miquelr02/Miquel_Rodriguez_PLC4UNI/Diseño Electiva/Planos de la caja/Parte superior de lateral 1.jpg

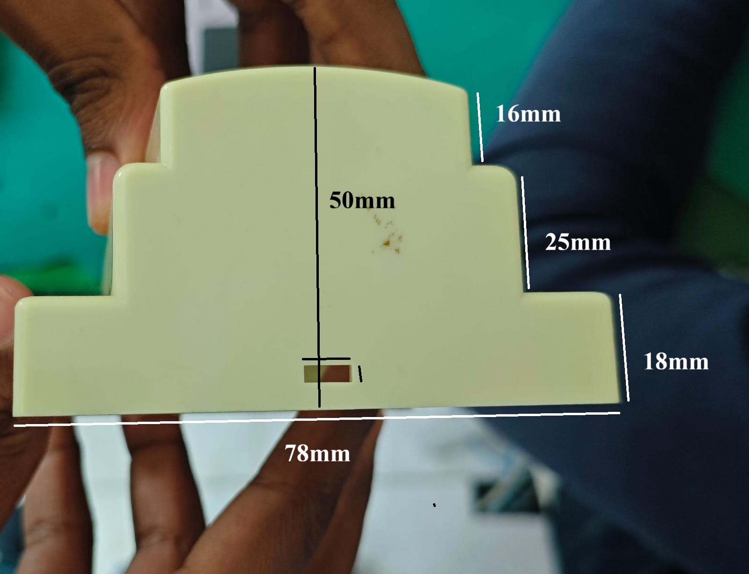
Diseño Electiva/Planos de la caja/Parte superior de lateral 1.jpg
