miquelr02/Miquel_Rodriguez_PLC4UNI/Tarea/Plantilla Especificación de requisitos de software Miquel.docx

Miquel Rodríguez Pimentel

2018-6619

Electiva mecatrónica

Especificación de requisitos de software

Proyecto: PLC 4UNI

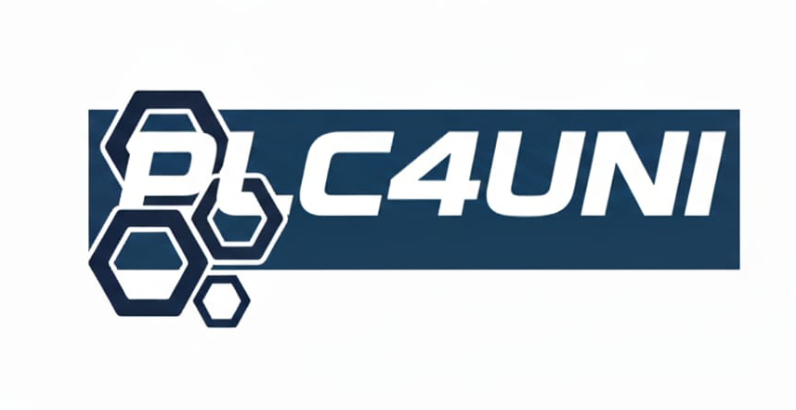
[picture p3: figure]

| | Septiembre 2025

Instrucciones para el uso de este formato

Este formato es una plantilla tipo para documentos de requisitos del software.

Está basado y es conforme con el estándar IEEE Std 830-1998.

Las secciones que no se consideren aplicables al sistema descrito podrán de forma justificada indicarse como no aplicables (NA).

Notas:

Los textos en color azul son indicaciones que deben eliminarse y, en su caso, sustituirse por los contenidos descritos en cada apartado.

Los textos entre corchetes del tipo “” permiten la inclusión directa de texto con el color y estilo adecuado a la sección, al pulsar sobre ellos con el puntero del ratón.

Los títulos y subtítulos de cada apartado están definidos como estilos de MS Word, de forma que su numeración consecutiva se genera automáticamente según se trate de estilos “Titulo1, Titulo2 y Titulo3”.

La sangría de los textos dentro de cada apartado se genera automáticamente al pulsar Intro al final de la línea de título. (Estilos Normal indentado1, Normal indentado 2 y Normal indentado 3).

El índice del documento es una tabla de contenido que MS Word actualiza tomando como criterio los títulos del documento.

Una vez terminada su redacción debe indicarse a Word que actualice todo su contenido para reflejar el contenido definitivo.

De la plantilla de formato del documento © & Coloriuris http://www.qualitatis.org

# Ficha del documento

Fecha | Revisión | Autor | Verificado dep. calidad.
Sept 2025 | 16/09 | Miquel Rodríguez Pimentel

Documento validado por las partes en fecha:

Por el cliente | Por la empresa suministradora
Fdo. D./ Dña | Fdo. D./Dña

# Contenido

# 1 Introducción

La introducción de la Especificación de requisitos de software (SRS) debe proporcionar una vista general de la SRS. Debe incluir el objetivo, el alcance, las definiciones y acrónimos, las referencias, y la vista general del SRS.

En el presente documento vamos dilucidar el proceso de desarrollo de un PLC educativo, pensado para estudiantes y su desarrollo al menos al inicio de su aprendizaje y que esta sea una herramienta fácil de conseguir, a un buen precio y además fácil de usar para cualquier automatización para principiantes.

El objetivo es que este PLC se convierta en un apoyo para todo el proceso del aprendizaje de los estudiantes, permitiendo algún margen de error sin daños graves al equipo. Una idea menos costosa e igual de efectiva.

## 1.1 Propósito

- Propósito del documento
- Audiencia a la que va dirigido

El propósito principal es definir los componentes, pasos y especificaciones para hacer un PLC que sea accesible para los estudiantes y que facilite el desarrollo en el área de automatización.

Este va dirigido a docentes, estudiantes, programadores y a instituciones que estén interesados en adquirir un dispositivo practico, funcional y accesible para su desarrollo en la automatización.

## 1.2 Alcance

- Identificación del producto(s) a desarrollar mediante un nombre
- Consistencia con definiciones similares de documentos de mayor nivel (ej. Descripción del sistema) que puedan existir

PLC 4UNI es un controlador lógico programable habilitado para estudiantes y principiantes en el área de la automatización, para que se les haga más económico y eficiente encontrar un equipo de estas características.

## 1.3 Personal involucrado

Nombre | Electiva de diseño mecatrónico
Rol | Desarrollo de diseño y hardware del PLC
Categoría profesional | Mecatrónica dirigida a automatización
Responsabilidades | Diseñar la interfaz y supervisar el desarrollo del PLC.
Información de contacto | 20186619tla.edu.do
Aprobación | Carlos Pichardo Viuque

Relación de personas involucradas en el desarrollo del sistema, con información de contacto.

Esta información es útil para que el gestor del proyecto pueda localizar a todos los participantes y recabar la información necesaria para la obtención de requisitos, validaciones de seguimiento, etc.

## 1.4 Definiciones, acrónimos y abreviaturas

Definición de todos los términos, abreviaturas y acrónimos necesarios para interpretar apropiadamente este documento. En ella se pueden indicar referencias a uno o más apéndices, o a otros documentos.

- PLC: Dispositivo electrónico que permite automatizar y controlar procesos mediante programación, en este caso con fines educativos.
- Sensor: Componente que detecta cambios en el entorno como luz, temperatura o posición y envía señales al PLC.
- Actuador: Dispositivo que recibe señales del PLC para realizar acciones específicas, como encender una luz o accionar un motor.
- GUI: (Graphical User Interface) Interfaz gráfica de usuario.
- IO: Inputs/Outputs (entradas y salidas de datos).
- EDU: Indica que el producto es de uso educativo.
- Señales digitales: Señales que solo pueden estar en dos estados (0 y 1), utilizadas para lógica de control.

## 1.5 Referencias

Ref | Titulo | Ruta | Fecha | Autor
1 | Manual del PLC educativo | /Documentos/PLC_Educativo/Manual.pdf | 1/09/2025 | Equipo de desarrollo
2 | Guía de programación de PLC | /Documentos/PLC_Educativo/Guía_Programacion.pdf | 20/08/2025 | Equipo de desarrollo

Relación completa de todos los documentos relacionados en la especificación de requisitos de software, identificando de cada documento el titulo, referencia (si procede), fecha y organización que lo proporciona.

## 1.6 Resumen

- Descripción del contenido del resto del documento
- Explicación de la organización del documento

Descripción del contenido: El documento incluye el propósito y alcance del proyecto, los términos y acrónimos necesarios, referencias de soporte, personal involucrado y sus responsabilidades, así como los requisitos funcionales y no funcionales del PLC. Se detallan las características de la interfaz, colores y funcionalidades diseñadas especialmente para estudiantes.

Organización del documento: La información se organiza de manera que el lector pueda comprender primero el objetivo y alcance, luego los términos clave y referencias, seguido por el personal responsable y finalmente los requisitos y funcionalidades del sistema, proporcionando una visión completa y coherente del PLC educativo y sus usos en un entorno académico.

# 2 Descripción general

## 2.1 Perspectiva del producto

El PLC educativo es un producto independiente, diseñado específicamente para fines académicos y de formación práctica en el área de la automatización y el control. Su desarrollo no depende de un sistema mayor, aunque puede complementarse con equipos de laboratorio como sensores, actuadores, simuladores y software de programación, lo que amplía sus posibilidades de uso en actividades educativas.

Este producto busca ofrecer a los estudiantes, un entorno seguro y sencillo para experimentar con lógica de control, programación y manejo de señales digitales y analógicas. Gracias a su interfaz intuitiva y su diseño visual con colores cálidos y suaves, se integra de manera amigable en entornos de aprendizaje, fomentando la participación y la comprensión de los conceptos.

## 2.2 Funcionalidad del producto

EL PLC educativo esta diseñado para ofrecer a los estudiantes una herramienta práctica y sencilla con la cual puedan comprender los fundamentos de la programación y el control de procesos automatizados. Sus funciones principales son:

Programación básica avanzada: Permite a los estudiantes crear, modificar y ejecutar programas de control mediante un entorno accesible y pensando para la enseñanza.

Manejo de entradas y salidas: Reconoce señales digitales y analógicas provenientes de sensores, y envía señales de control hacia actuadores como luces, motores o alarma

Interfaz amigable: Cuenta con un sistema de uso intuitivo, con indicadores visuales claros y un diseño en colores cálidos y suaves que favorecen la concentración y el aprendizaje

Simulación educativa: Posibilita la recreación de escenarios sencillos de automatización, permitiendo que los estudiantes prueben y entiendan la lógica de control.

## 2.3 Características de los usuarios

Tipo de usuario | Estudiantes de técnico superior y universitarios
Formación | Conocimientos básicos en electrónica, electricidad y automatización
Habilidades | Capacidad par seguir instrucciones de practicas de laboratorio, interpretar esquemas sencillos, realizar conexiones básicas de sensores y actuadores.
Actividades | Los usuarios emplearán el PLC para desarrollar ejercicios prácticos de automatización, aprender lógica de control, probar programas en escenarios simulados y ejecutar automatización que integre sensores y actuadores.

Descripción de los usuarios del producto, incluyendo nivel educacional, experiencia y experiencia técnica.

## 2.4 Restricciones

Descripción de aquellas limitaciones a tener en cuenta a la hora de diseñar y desarrollar el sistema, tales como el empleo de determinadas metodologías de desarrollo, lenguajes de programación, normas particulares, restricciones de hardware, de sistema operativo etc.

El diseño y desarrollo del PLC presenta algunas limitaciones que deben ser tomadas en cuenta para garantizar su correcto funcionamiento y accesibilidad en el entorno académico:

- Hardware limitado: El dispositivo contará con una cantidad reducida de entradas y salidas digitales y analógicas, suficientes para fines educativos, pero no para aplicaciones industriales.
- Lenguaje de programación: Se utilizará un lenguaje sencillo, estandarizado y que se enfoque en el mercado para reforzar el aprendizaje y que este pueda llevar al campo laboral.
- Compatibilidad de software: El sistema esta diseñado para funcionar en sistemas operativos comunes como Windows y Linux, evitando instalaciones y búsquedas de otros sistemas.
- Normas de seguridad: El producto debe cumplir con estándares básicos de seguridad eléctrica y de laboratorio, evitando riesgos para los estudiantes.
- Acceso a hardware educativo básico: Se considera que los estudiantes tendrán acceso a sensores y actuadores simples para realizar prácticas. La falta de estos componentes limitaría el aprendizaje.
- Recursos de laboratorio: Se espera que el dispositivo se utilice en lugares con energía eléctrica estable y condiciones seguras de laboratorio. Si estas condiciones no están garantizadas el uso del PLC puede verse restringido.

## 2.5 Suposiciones y dependencias

Descripción de aquellos factores que, si cambian, pueden afectar a los requisitos. Por ejemplo, una asunción puede ser que determinado sistema operativo está disponible para el hardware requerido. De hecho, si el sistema operativo no estuviera disponible, la SRS debería modificarse.

El desarrollo del PLC se apoya en ciertos factores que se consideran estables, pero al tener variación en alguno de ellos podrían afectar los requisitos.

- Disponibilidad de sistemas operativos comunes: Asumiendo que todos los equipos posean Windows o Linux.
- Acceso y hardware educativo básico: Se considera que los estudiantes tendrán acceso a sensores y actuadores simples para realizar las practicas.
- Recursos de laboratorios: Se asume que el producto será utilizado en entornos con energía eléctrica estable y condiciones seguras de laboratorio. Si estas condiciones no se garantizan el uso del PLC se verá restringido.

## 2.6 Evolución previsible del sistema

Identificación de futuras mejoras al sistema, que podrán analizarse e implementarse en un futuro.

Esta pensado como una primera versión funcional y accesible, pero se prevé que mas adelante pueda actualizar y mejorar capacidades para adaptarse a nuevas necesidades de enseñanza.

- Ampliación de entradas y salidas: Incorporar mayor número de puertos digitales y analógicos
- Conectividad inalámbrica: Añadir soporte para Wi-Fi o bluetooh facilitando la conexión con dispositivos móviles o entornos de simulación en la nube.
- Entorno de programación: Incluir lenguajes visuales (en bloques) o integración de plataformas como Arduino o Python, para mayor diversificación del aprendizaje.
- Compatibilidad multiplataforma: Extender el uso del software a sistemas operativos adicionales, incluyendo macOS y aplicaciones móviles.

# 3 Requisitos específicos

Número de requisito | RF-027
Nombre de requisito | Entradas digitales configurables
Tipo | [ ] Requisito | [ ] Restricción
Fuente del requisito | Necesidad educativa/practica de control básico
Prioridad del requisito | [ ] Alta/Esencial | [ ] Media/Deseado | [ ] Baja/ Opcional

## 3.1 Requisitos comunes de los interfaces

### 3.1.1 Interfaces de usuario

El sistema contará con una interfaz gráfica amigable e intuitiva para estudiantes y docentes, con las siguientes características:

- Pantalla principal con menú de opciones
- Editor de programas con bloques gráficos y código textual
- Colores diferenciados para entradas, salidas y operaciones lógicas
- Mensajes de error y de alertas claros en caso de advertencias o error en alguna configuración
- Panel de simulación en tiempo real que muestre el estado de las entradas y las salidas.

### 3.1.2 Interfaces de hardware

El sistema deberá contar con conexiones físicas para interactuar con el entorno.

- Entradas digitales: Mínimo 8, compatibles con sensores de 24 VDC.
- Entradas analógicas: Mínimo 2, rango 0-10 V para potenciómetros o transductores.
- Salidas digitales: Mínimo 8, tipo rele o transistor para control de actuadores.
- Puerto USB: Para conexión con la PC y carga de programas.
- Pantalla LCD: Para mostrar estados básicos sin PC.

### 3.1.3 Interfaces de comunicación

Describir los requisitos del interfaces de comunicación si hay comunicaciones con otros sistemas y cuales son las protocolos de comunicación.

El sistema deberá integrarse con software complementarios para su programación y simulación:

- IDE propio (software educativo del PLC)
1. Permitir programación, simulación y carga al hardware.
2. Formato de interfaz: archivos de proyecto
- Exportación de datos: compatibilidad para guardar programas en formato texto.
- Integracion opcional: con software SCADA educativo mediante protocolo OPC-UA.

## 3.2 Requisitos funcionales

El software deberá realizar las siguientes acciones principales:

- Validación de entradas antes de su procesamiento (valores dentro del rango permitido).
- Procesamiento de la lógica definida por el usuario
- Generación de salidas en función de entradas y condiciones programadas.
- Manejo de errores y recuperación automática en caso de fallos de comunicación o ejecución.
- Registro de eventos y resultados de simulación para retroalimentación al usuario.

### 3.2.1 Requisito funcional 1

Nombre: Validación de entradas

Descripción: El sistema verificara que las señales de entrada estén dentro del rango permitido antes de procesarlas

### 3.2.2 Requisito funcional 2

Nombre: Ejecución de lógica de control.

Descripción: El sistema deberá ejecutar la lógica programada por el usuario de acuerdo con las instrucciones definidas.

### 3.2.3 Requisito funcional 3

Nombre: Simulación en tiempo real

Descripción: El software permitirá al usuario simular el comportamiento del programa sin necesidad de cargarlo en el hardware.

### 3.2.4 Requisito funcional n

Nombre: Comunicación con hardware PLC.

Descripción: El sistema deberá enviar y recibir datos correctamente entre el software de programación y el hardware del PLC a través del USB.

## 3.3 Requisitos no funcionales

### 3.3.1 Requisitos de rendimiento

- El sistema debe permitir la ejecución de hasta 20 usuarios simultáneos en la plataforma de simulación sin degradar el rendimiento.
- El 95% de las operaciones (compilación, carga de programa y simulación) deberán completarse en menos de 2 segundos.
- El hardware del PLC debe poder procesar programas de hasta 200 instrucciones sin pérdida de velocidad.
- El software debe poder gestionar un promedio de 50 interacciones por minuto durante las practicas sin fallos.

### 3.3.2 Seguridad

- El acceso al software estará protegido por usuarios y contraseñas diferenciados para estudiantes y docentes.
- Se implementarán logs de actividad que registren acciones críticas.
- Toda comunicación entre PC y PLC deberá usar protocolo seguro (ej. Cifrado básico en USB o Modbus).
- El sistema verificará la integridad de archivos de programas antes de cargarlos en el hardware para evitar fallos maliciosos o accidentales.

### 3.3.3 Fiabilidad

- El sistema deberá tener tasa de error menor al 2% en operaciones de compilación y carga.
- El hardware del PLC deberá mantener un tiempo medio entre fallos (MTBF) mínimo de 5000 horas.
- El software deberá recuperarse automáticamente en caso de pérdida de conexión con PLC en un máximo de 5 segundos.

### 3.3.4 Disponibilidad

- El sistema deberá estar disponible al menos 99% del tiempo de uso en horario académico (8:am-8:00 pm).
- Las actualizaciones del software no deberán dejarlo inactivo por más de 2 horas seguidas.
- El hardware sebera encender y estar listo para uso en un máximo de 15 segundos.

### 3.3.5 Mantenibilidad

- El software deberá permitir actualizaciones periódicas sin necesidad de reinstalar completamente el sistema.
- El equipo de desarrollo será responsable del mantenimiento correctivo (errores y fallos).
- Los docentes podrán realizar mantenimiento preventivo, como la generación de reportes semanales de uso y estadística de acceso.
- Las tareas de mantenimiento no deberán superar el 5% del tiempo de operación mensual.

### 3.3.6 Portabilidad

- El software deberá funcionar en Windows 10 o superior y ser adaptable a Linux en futuras versiones.
- Al menos el 80% del código fuente será independiente del sistema operativo, garantizado su migración otros entornos.}
- Los programas desarrollados deberán exportarse en formatos estándar para reutilización en otras plataformas.
- La aplicación deberá poder ejecutarse en equipos con mínimo 4 GB de RAM y procesador i3 o equivalente.

## 3.4 Otros requisitos

- Requisitos culturales y educativos: El sistema debe estar disponible en idioma español, con opción futura a inglés para facilitar su uso internacional.
- Requisitos legales: Cumplir con normativas de seguridad eléctrica (24 VDC seguro) y licencias de software libre o académico.
- Requisitos políticos: El producto debe alinearse con programas nacionales de educación técnica y profesional.

# 4 Apéndices

En esta sección se podrán incluir:

- Diagramas eléctricos y de conexión del PLC.
- Ejemplos de prácticas preconfiguradas.
- Glosario de símbolos usados en diagramas ladder.
- Manuales de usuario y guías rápidas para estudiantes u y docentes.

Descripción de requisitos del sofware

Modelo de ingeniería [Nombre documento] 0.3 Pág. 3

PLC 4UNI Especificación de requisitos de software Electiva Pág. 5

Especificación de requisitos de software Rev. Pág. 4
