miquelr02/Miquel_Rodriguez_PLC4UNI/Diseño Electiva/Planos de la caja/parte inferior de lateral 1.jpg

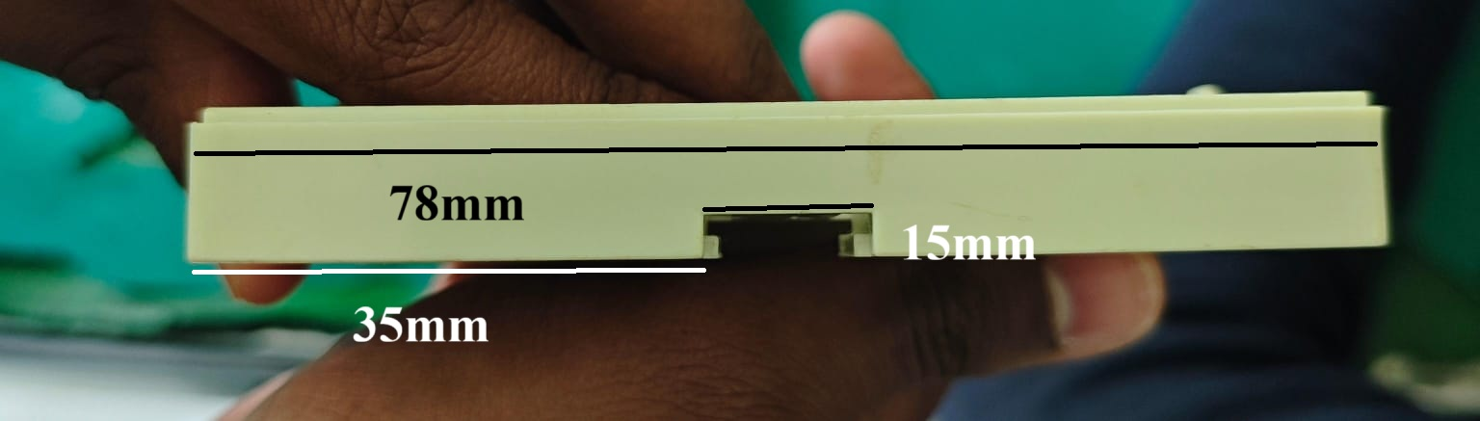
Diseño Electiva/Planos de la caja/parte inferior de lateral 1.jpg
