miquelr02/Miquel_Rodriguez_PLC4UNI/Render/Render de frente.png

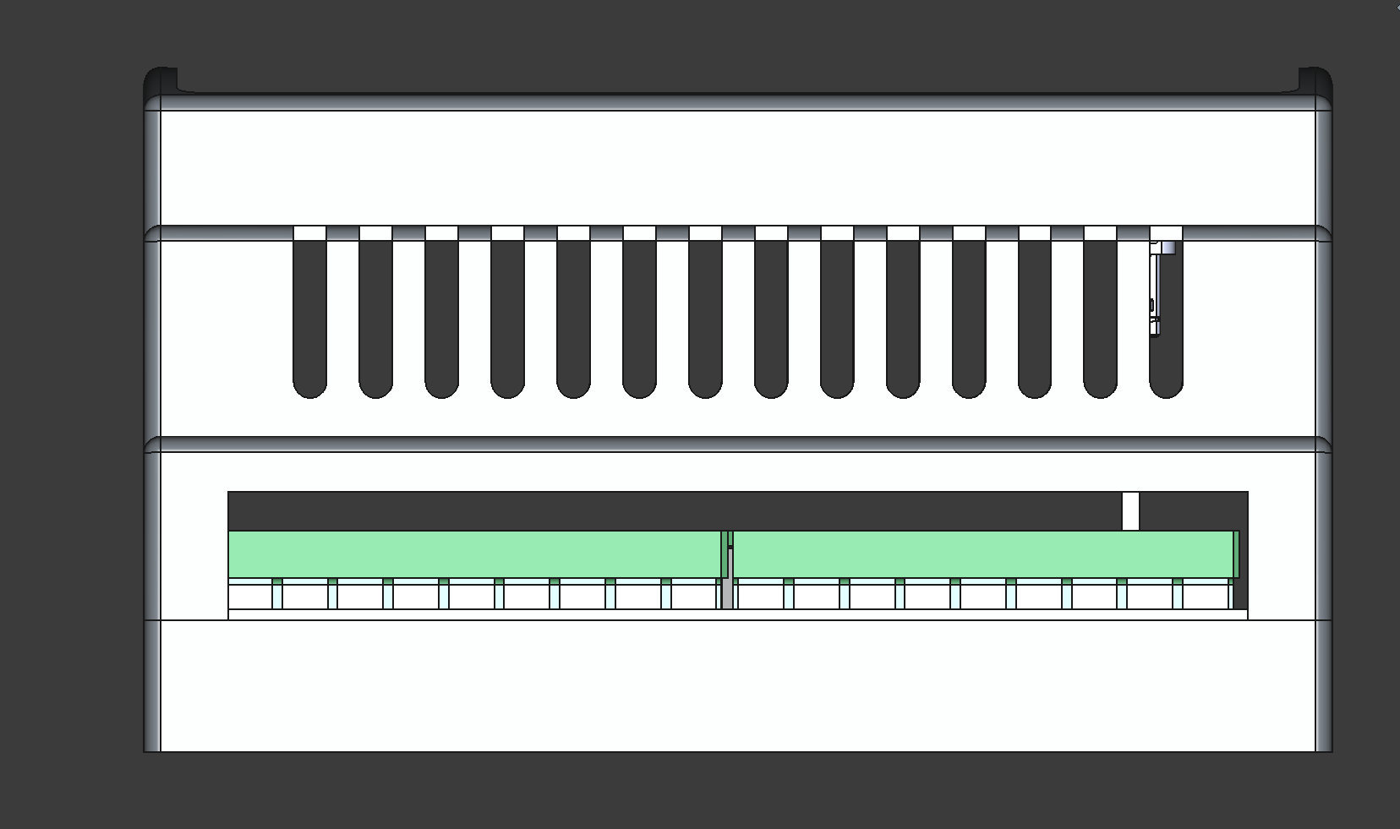
Render/Render de frente.png
