miquelr02/Miquel_Rodriguez_PLC4UNI/Render/Render Lateral con etiqueta.png

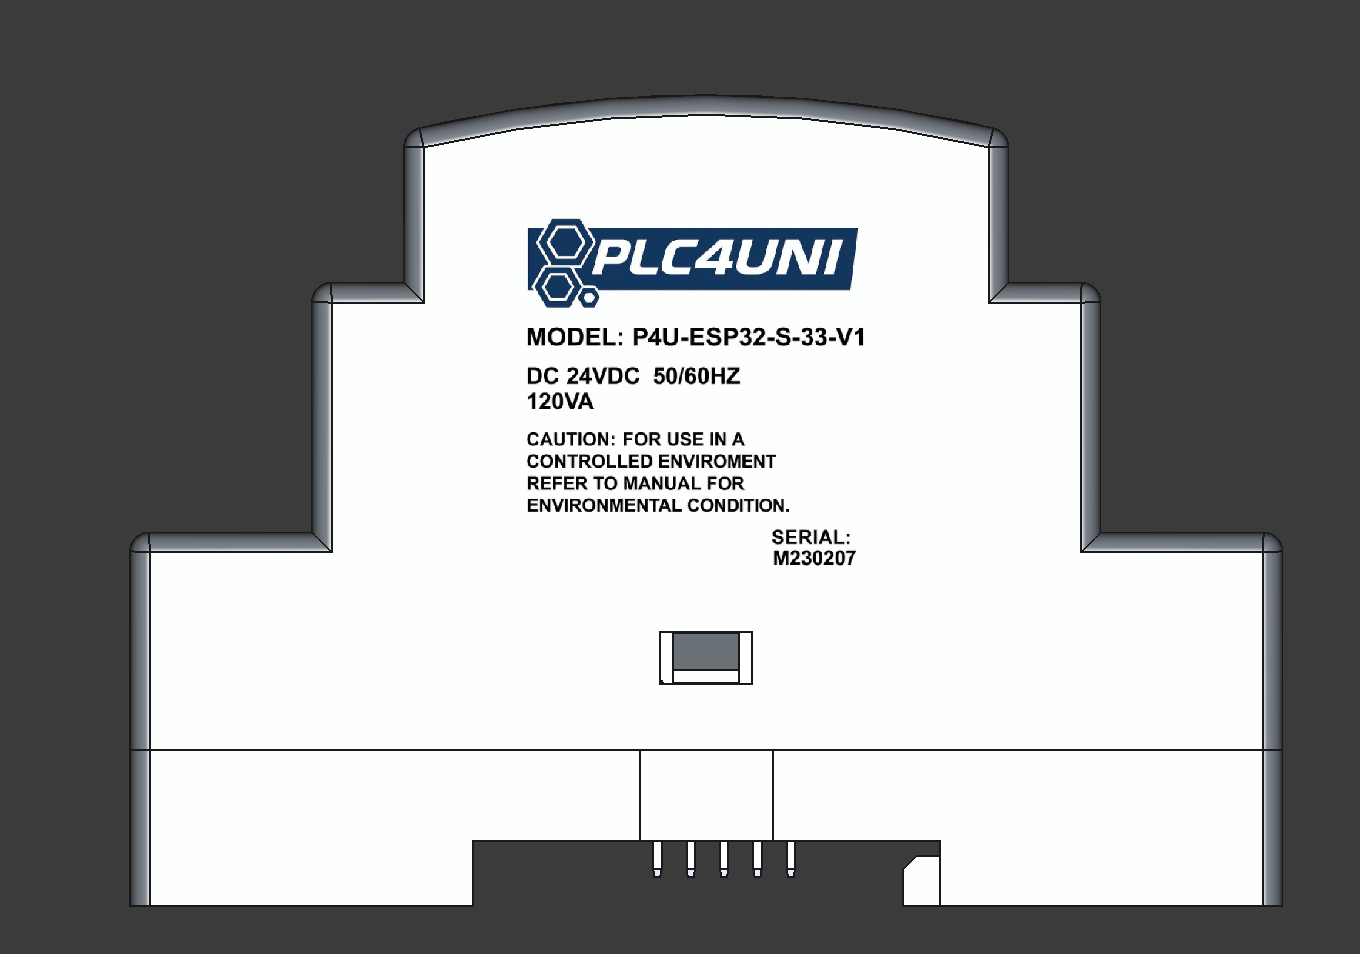
Render/Render Lateral con etiqueta.png
