miquelr02/Miquel_Rodriguez_PLC4UNI/Render/Render Vista Isométrica.png

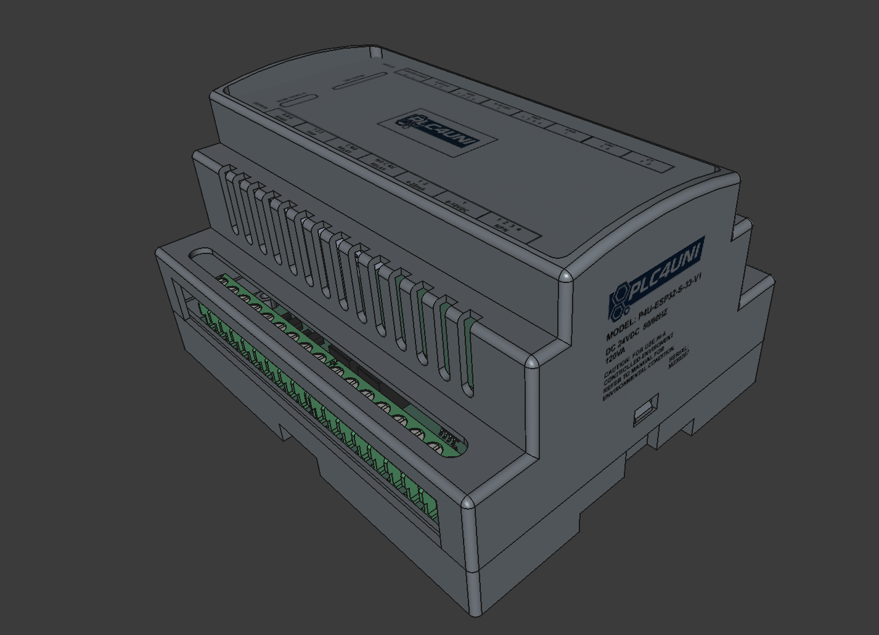
Render/Render Vista Isométrica.png
