miquelr02/Miquel_Rodriguez_PLC4UNI/Render/RENDER.png

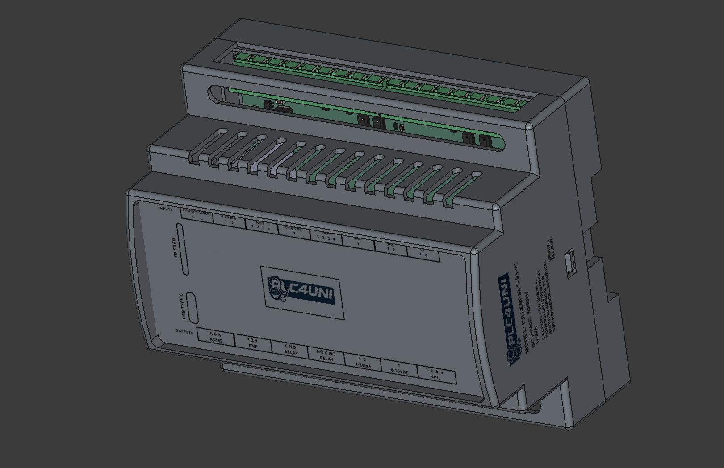
Render/RENDER.png
