miquelr02/Miquel_Rodriguez_PLC4UNI/Diseño Electiva/FreeCad/Inferior.FCStd

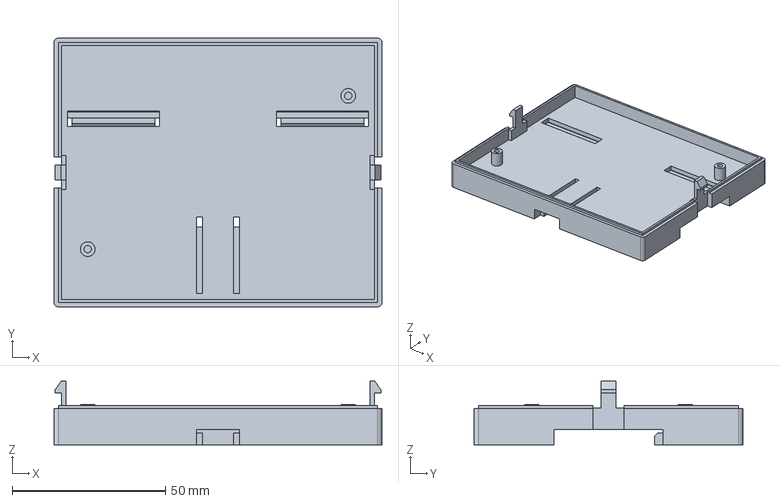
[picture p11: CAD file, 2025-10-09]
Diseño Electiva/FreeCad/Inferior.FCStd
107.0 x 87.7 x 20.8 mm
