miquelr02/Miquel_Rodriguez_PLC4UNI/Tarea 4/MSD-4-A (1).step

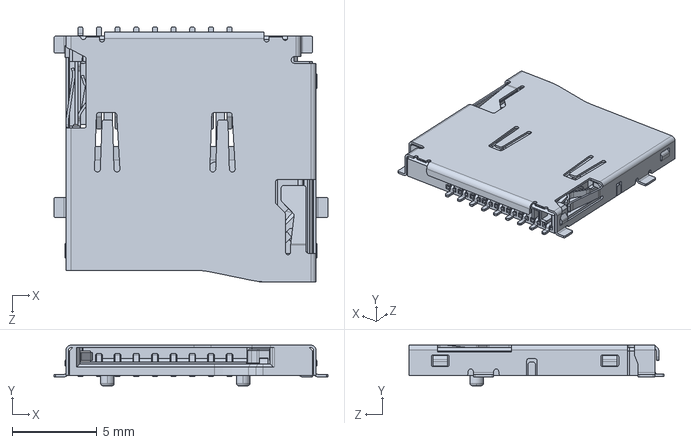
[picture p12: CAD file, 2025-12-12]
Tarea 4/MSD-4-A (1).step
16.1 x 2.40 x 15.0 mm
