miquelr02/Miquel_Rodriguez_PLC4UNI/Diseño Electiva/FreeCad/Superior.FCStd

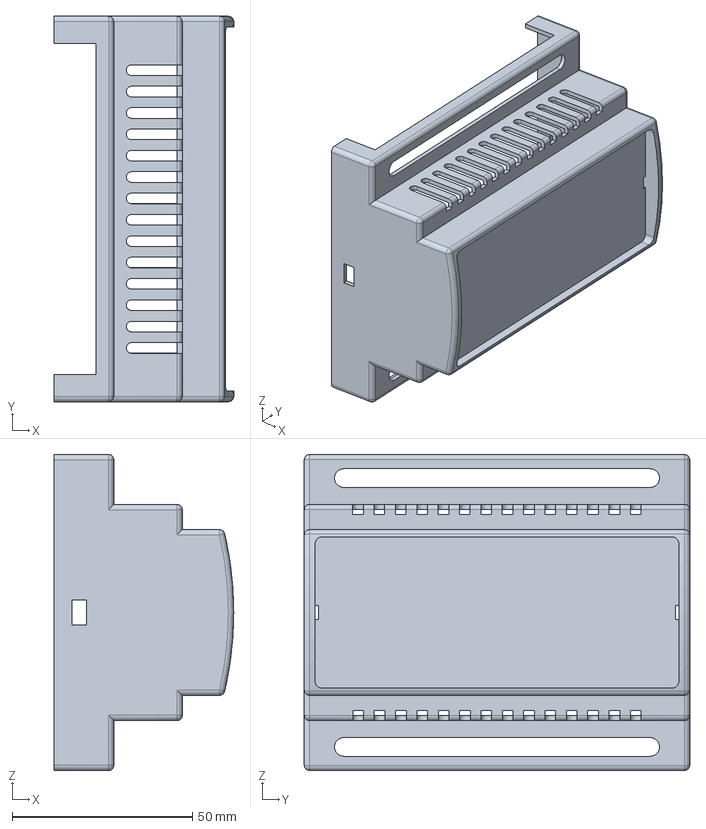
[picture p13: CAD file, 2025-10-09]
Diseño Electiva/FreeCad/Superior.FCStd
49.8 x 107.0 x 87.7 mm
