miquelr02/Miquel_Rodriguez_PLC4UNI/Tarea 4/USB Type C Port (SMD Type).STEP

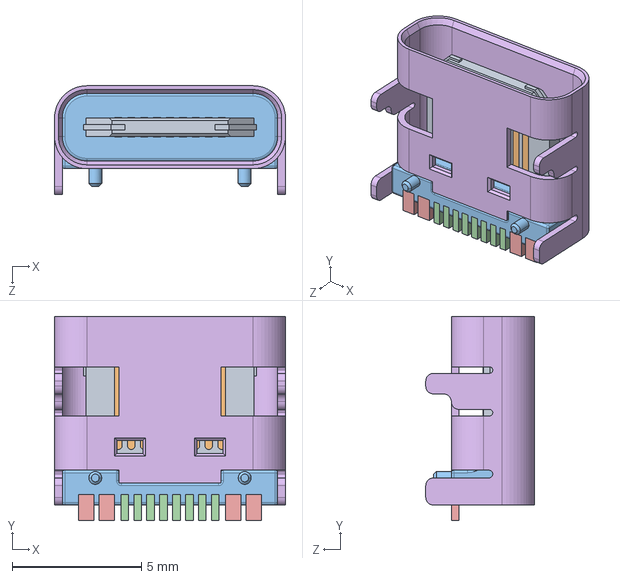
[picture p14: CAD file, 2025-12-12]
Tarea 4/USB Type C Port (SMD Type).STEP
8.94 x 7.90 x 4.20 mm
