miquelr02/Miquel_Rodriguez_PLC4UNI/Tarea 4/2x5 Male Pin Header .STEP

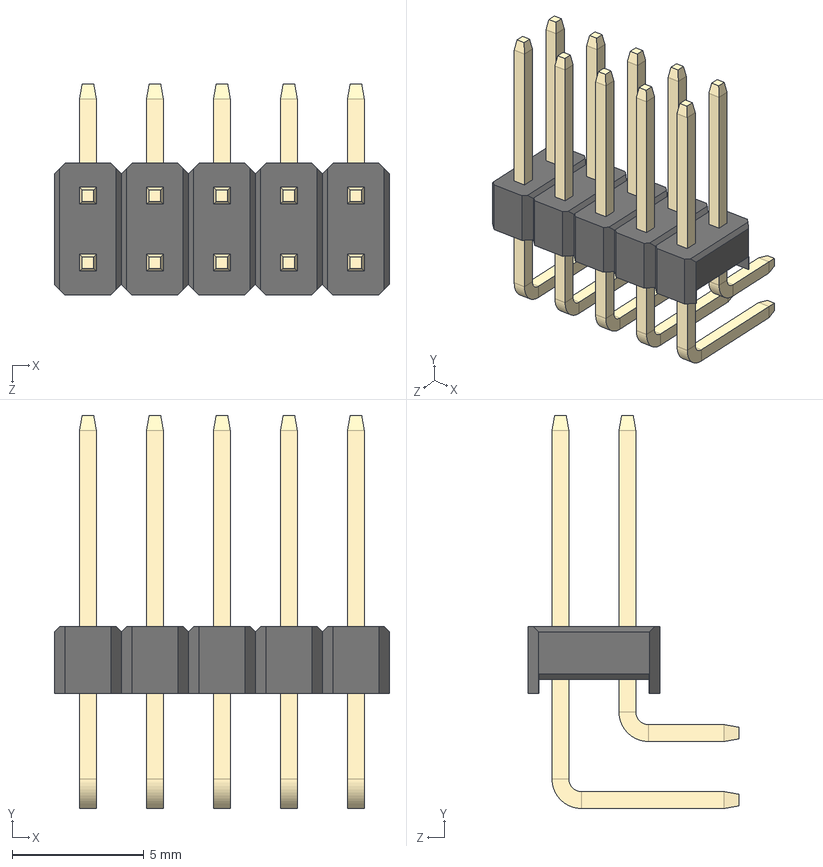
[picture p15: CAD file, 2025-12-12]
Tarea 4/2x5 Male Pin Header .STEP
12.7 x 14.9 x 8.00 mm
