miquelr02/Miquel_Rodriguez_PLC4UNI/Tarea 4/PCB Vertical .DXF

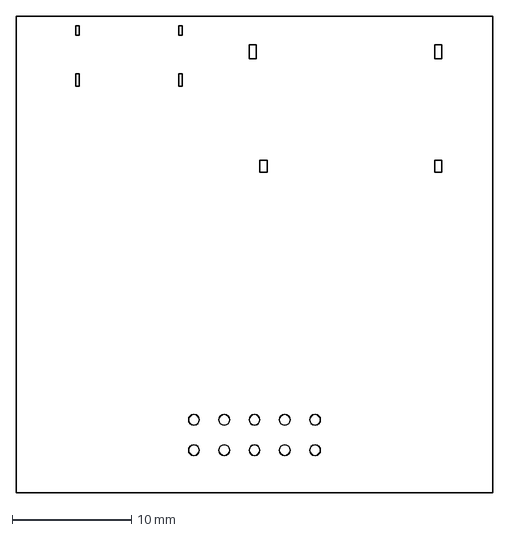
[picture p16: CAD file, 2025-12-12]
Tarea 4/PCB Vertical .DXF
40.0 x 40.0 mm
