miquelr02/Miquel_Rodriguez_PLC4UNI/Tarea 4/PLC4uni.FCStd

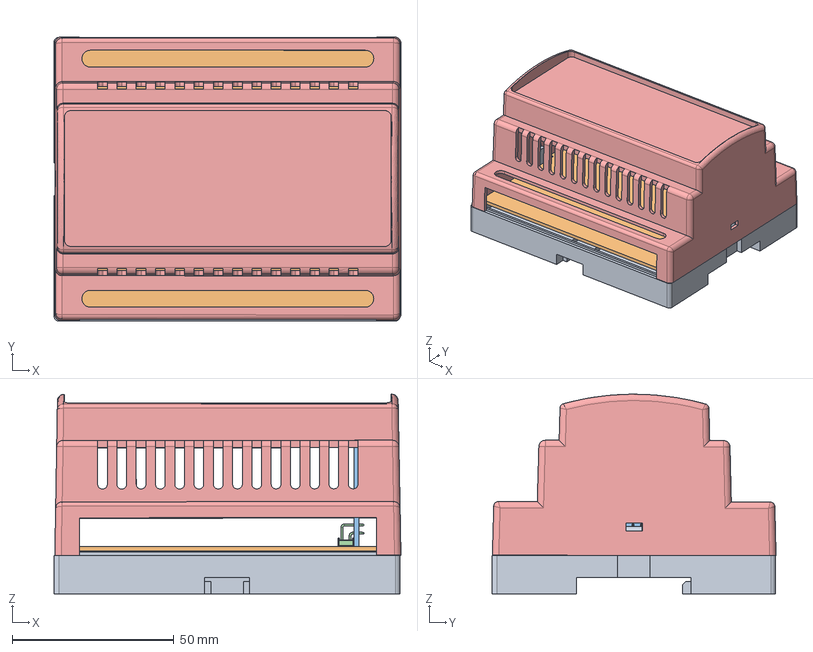
[picture p17: CAD file, 2025-12-12]
Tarea 4/PLC4uni.FCStd
107.2 x 87.8 x 61.7 mm
PLC–4–UNI–209 Franjelis L._001
PLC4uni PCB_001
PLC4uni PCB_Vertical_001
2x5 male PIn Header Angle_001
PLC Part-1_001
