miquelr02/Miquel_Rodriguez_PLC4UNI/Tarea 3/Nivara.kicad_pcb

## KiCad design Tarea 3/Nivara.kicad_pcb (2025-12-01)

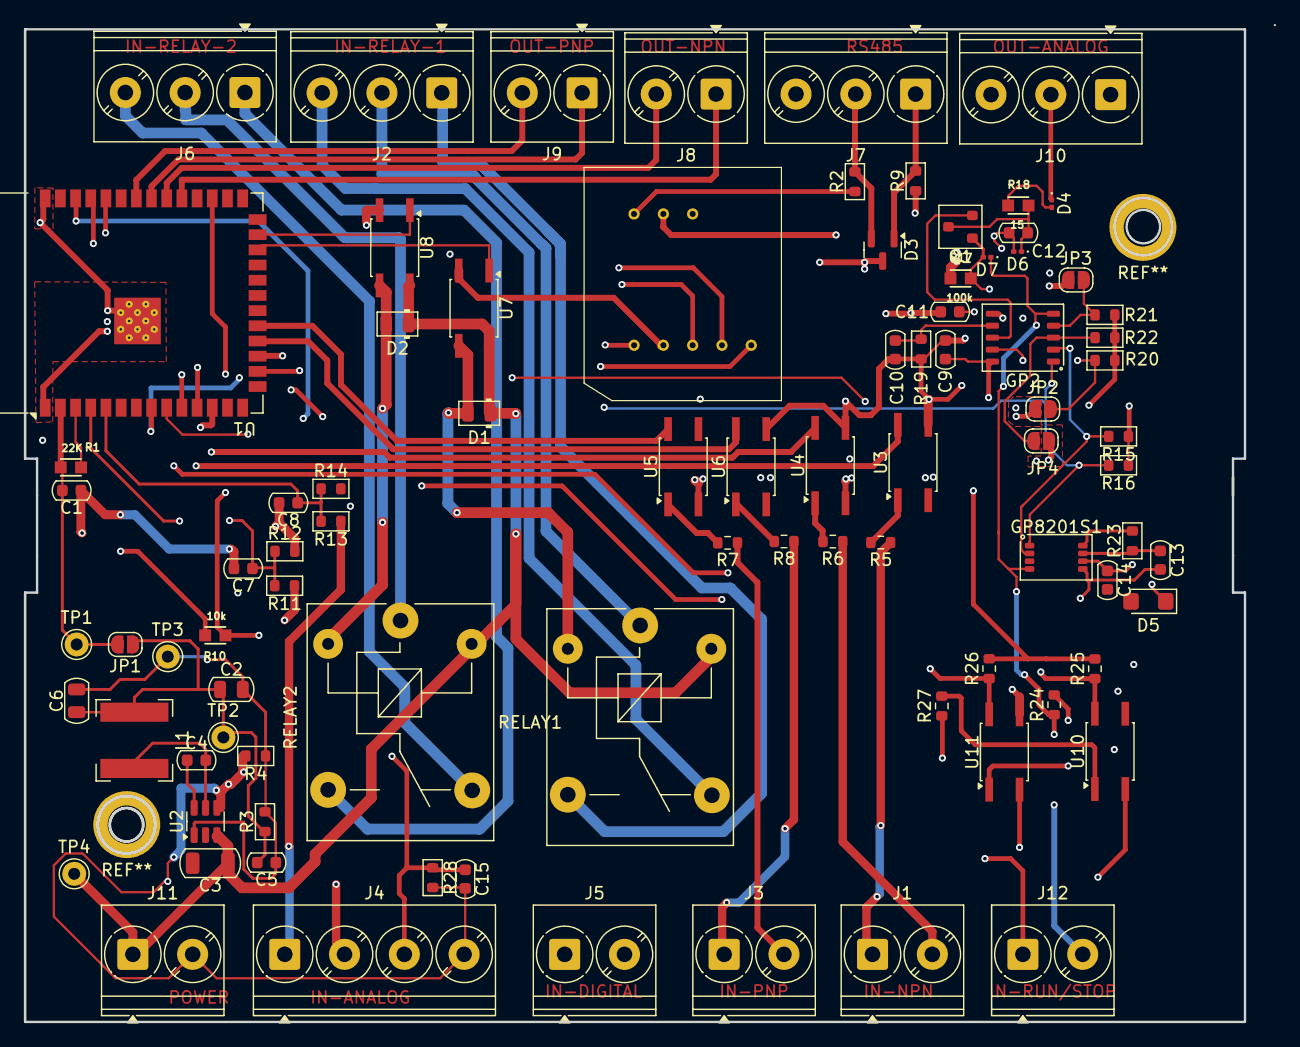
[picture p19: board Nivara.kicad_pcb from above]

Board: 4 copper layers, 104.5 x 83.3 mm, 87 parts (0 on the bottom side), 68 nets.

Parts:
C1, C9, C11, C13: 1uF; C_0603_1608Metric
C2, C6: 22uF; C_0805_2012Metric
C3: 10uF; C_1206_3216Metric
C4, C7, C8, C14, C15: 100nF; C_0603_1608Metric
C5: 100PF; C_0603_1608Metric
C10: 220pF; C_0603_1608Metric
C12: 0.1uF; C_0603_1608Metric
D1, D2: CD4148WS; D_0805_2012Metric
D3: SM712_SOT23; SOT-23
D4: 1N4007; D_0201_0603Metric
D5: SMF24A; D_SMF
D6, D7: SMF24A; D_0201_0603Metric
GP2: SSOP-10_3.9x4.9mm_P1.00mm
GP8201S1: OnSemi_Micro8
J1: IN-NPN; TerminalBlock_Phoenix_PT-1,5-2-5.0-H_1x02_P5.00mm_Horizontal
J2: IN-RELAY-1; TerminalBlock_Phoenix_PT-1,5-3-5.0-H_1x03_P5.00mm_Horizontal
J3: IN-PNP; TerminalBlock_Phoenix_PT-1,5-2-5.0-H_1x02_P5.00mm_Horizontal
J4: IN-ANALOG; TerminalBlock_Phoenix_PT-1,5-4-5.0-H_1x04_P5.00mm_Horizontal
J5: IN-DIGITAL; TerminalBlock_Phoenix_PT-1,5-2-5.0-H_1x02_P5.00mm_Horizontal
J6: IN-RELAY-2; TerminalBlock_Phoenix_PT-1,5-3-5.0-H_1x03_P5.00mm_Horizontal
J7: RS485; TerminalBlock_Phoenix_PT-1,5-3-5.0-H_1x03_P5.00mm_Horizontal
J8: OUT-NPN; TerminalBlock_Phoenix_PT-1,5-2-5.0-H_1x02_P5.00mm_Horizontal
J9: OUT-PNP; TerminalBlock_Phoenix_PT-1,5-2-5.0-H_1x02_P5.00mm_Horizontal
J10: OUT-ANALOG; TerminalBlock_Phoenix_PT-1,5-3-5.0-H_1x03_P5.00mm_Horizontal
J11: POWER; TerminalBlock_Phoenix_PT-1,5-2-5.0-H_1x02_P5.00mm_Horizontal
J12: IN-RUN/STOP; TerminalBlock_Phoenix_PT-1,5-2-5.0-H_1x02_P5.00mm_Horizontal
JP1, JP2, JP3, JP4: SolderJumper_2_Open; SolderJumper-2_P1.3mm_Open_RoundedPad1.0x1.5mm
L1: 6.8uH; L_Bourns-SRN6028
Q1: AO3401A; SOT-23
R1: 22K; R_0603
R2, R9, R28: 120; R_0603_1608Metric
R3, R4: 22k; R_0603_1608Metric
R5, R6, R7, R8, R24, R27: 910; R_0603_1608Metric
R10: 10k; R_0603
R11, R13: 51k; R_0603_1608Metric
R12, R14: 16k; R_0603_1608Metric
R15, R16: 4.7k; R_0603_1608Metric
R17: 100k; R_0603
R18: 15; R_0603
R19: 2.5k; R_0603_1608Metric
R20, R21, R22, R23: 10k; R_0603_1608Metric
R25, R26: 412; R_0603_1608Metric
RELAY1, RELAY2: SANYOU_SRD_Form_C; Relay_SPDT_SANYOU_SRD_Series_Form_C
TP1, TP2, TP3, TP4: TestPoint; Pin_D1.0mm_L10.0mm
U1: ESP32-S3-WROOM-1
U2: AP63200WU; TSOT-23-6
U3, U4, U5, U6, U7, U8, U10, U11: LTV-357TB; SO-4_4.4x3.6mm_P2.54mm
U9: RSM3485ECHT

Connections:
+3.3V: C1.2, JP1.2 (B), R1.1, R10.1, R15.1, R16.1, R25.2, R26.2, TP1.1, U1.2 (3V3), U9.1 (VCC)
/BOARD/ANAG_0-10-IN: J4.2, R11.1
/BOARD/ANAG_0-32-IN: J4.1, R13.1
/BOARD/ANAG_VOL-OUT: C14.1, D5.1 (A1), GP8201S1.6 (VOUT)
/BOARD/DIG_IN/OUT_DIGITAL_0: R25.1, U1.10 (IO17), U10.4
/BOARD/DIG_IN/OUT_DIGITAL_1: R26.1, U1.11 (IO18), U11.4
/BOARD/IN-PNP1: J3.1, R8.1
/BOARD/IN-PNP2: J3.2, R7.1
/BOARD/INPUT_NPN/OUTPUT_NPN1: U1.12 (IO8), U3.4
/BOARD/INPUT_NPN/OUTPUT_NPN2: U1.17 (IO9), U4.4
/BOARD/INPUT_PNP/OUTPUT-PNP1: U1.18 (IO10), U6.4
/BOARD/INPUT_PNP/OUTPUT-PNP2: U1.19 (IO11), U5.4
/BOARD/IN_DIGITAL_0: J5.2, U10.2
/BOARD/IN_DIGITAL_1: J5.1, U11.2
/BOARD/IN_NPN1: J1.1, R5.1
/BOARD/IN_NPN2: J1.2, R6.1
/BOARD/IN_mA-ANAG: C15.1, J4.3, R28.1, U1.38 (IO2)
/BOARD/OUTPUT-PNP1: J9.1, U1.33 (IO40)
/BOARD/OUTPUT-PNP2: J9.2, U1.34 (IO41)
/BOARD/OUTPUT_NPN1: J8.1, U1.31 (IO38)
/BOARD/OUTPUT_NPN2: J8.2, U1.32 (IO39)
/BOARD/OUT_4-20mA-ANAG: D4.1 (K), J10.2
/BOARD/RELA2_NO: J6.1, RELAY2.3
/BOARD/RELAY1_COS: J2.2, RELAY1.1
/BOARD/RELAY1_NC: J2.3, RELAY1.4
/BOARD/RELAY1_NO: J2.1, RELAY1.3
/BOARD/RELAY2_COS: J6.2, RELAY2.1
/BOARD/RELAY2_NC: J6.3, RELAY2.4
/BOARD/RELAY-SETUP/ACT_RELAY1: U1.24 (IO47), U7.1
/BOARD/RELAY-SETUP/ACT_RELAY2: U1.25 (IO48), U8.1
/BOARD/RS485-DRIVER/UART-IN: U1.37 (TXD0), U9.3 (TXD)
/BOARD/RS485-DRIVER/UART-OUT: U1.36 (RXD0), U9.4 (RXD)
/BOARD/RS485-DRIVER/~TX/RX: U1.16 (IO46), U9.5 (CON)
/BOARD/RS-485A: D3.1 (A1), J7.1, R9.2
/BOARD/RS-485B: D3.2 (A2), J7.2, R2.2
/BOARD/VOLTAGE entrada/ANAG_0-10-OUT: C7.1, R11.2, R12.1, U1.4 (IO4)
/BOARD/VOLTAGE entrada/ANAG_0-32-OUT: C8.1, R13.2, R14.1, U1.5 (IO5)
/BOARD/salida mA/SCLK_OUT: GP2.1 (SCLK), GP8201S1.1 (SCLK), R16.2, U1.9 (IO16)
/BOARD/salida mA/SDA_OUT: GP2.2 (SDA), GP8201S1.2 (SDA), R15.2, U1.8 (IO15)
/BOARD/~RUN/STOP: J12.1, R10.2, U1.29 (IO36)
GND: C1.1, C3.2, C7.2, C8.2, C9.2, C10.2, C11.2, C12.2, C13.2, C14.2, C15.2, D3.3 (common), D5.2 (A2), D6.2 (A2), GP2.6 (GND), GP8201S1.5 (GND), J4.4, J7.3, J10.3, J11.2, J12.2, JP2.1 (A), JP3.1 (A), JP4.1 (A), R4.2, R12.2, R14.2, R17.2, R19.2, R28.2, U1.1 (GND), U1.40 (GND), U1.41 (GND), U2.4 (GND), U3.2, U3.3, U4.2, U4.3, U5.2, U5.3, U6.2, U6.3, U7.2, U8.2, U9.2 (GND), U10.3, U11.3
unnamed: D1.2 (A), RELAY1.2, U7.3
unnamed: D2.2 (A), RELAY2.2, U8.3
unnamed: D4.2 (A), R18.2
unnamed: C12.1, D6.1 (A1), Q1.3 (D), R18.1
unnamed: C11.1, D7.2 (A2), Q1.1 (G), R17.1
unnamed: GP2.3 (A0), JP4.2 (B), R22.2
unnamed: GP2.4 (A1), JP3.2 (B), R21.2
unnamed: GP2.9 (A2), JP2.2 (B), R20.2
unnamed: C10.1, GP2.7 (SET), R19.1
unnamed: C9.1, GP2.10 (V5V), R20.1, R21.1, R22.1
unnamed: C13.1, GP8201S1.7 (SEL), R23.1
unnamed: GP8201S1.8 (V5V), R23.2
unnamed: C2.1, C5.2, C6.1, JP1.1 (A), L1.2, R3.1, TP2.1
unnamed: R5.2, U3.1
unnamed: R6.2, U4.1
unnamed: R7.2, U5.1
unnamed: R8.2, U6.1
unnamed: R24.2, U11.1
unnamed: R27.2, U10.1
unnamed: R1.2, U1.3 (EN)
unnamed: C4.1, U2.6 (BST)
unnamed: C2.2, C5.1, C6.2, R3.2, R4.1, TP3.1, U2.1 (FB)
unnamed: C4.2, L1.1, U2.5 (SW)
unnamed: R9.1, U9.9 (A)
unnamed: R2.1, U9.8 (B)
VCC: C3.1, D1.1 (K), D2.1 (K), D7.1 (A1), GP2.5 (VCC), GP8201S1.4 (VCC), J11.1, R24.1, R27.1, RELAY1.5, RELAY2.5, TP4.1, U2.2 (EN), U2.3 (IN), U7.4, U8.4
i_out: GP2.8 (IOUT), Q1.2 (S)
